ihowson/Enduro-Ebike/reference/CaV3_LinearTempSensorCalculator_v3.png

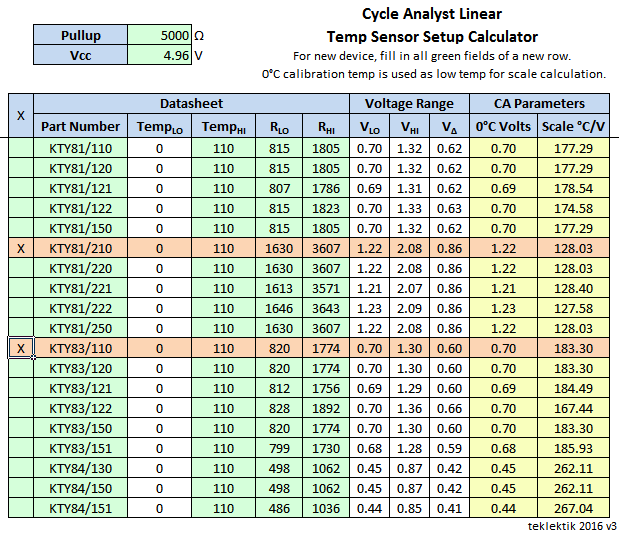
reference/CaV3_LinearTempSensorCalculator_v3.png
