ihowson/Enduro-Ebike/schematic-render.pdf

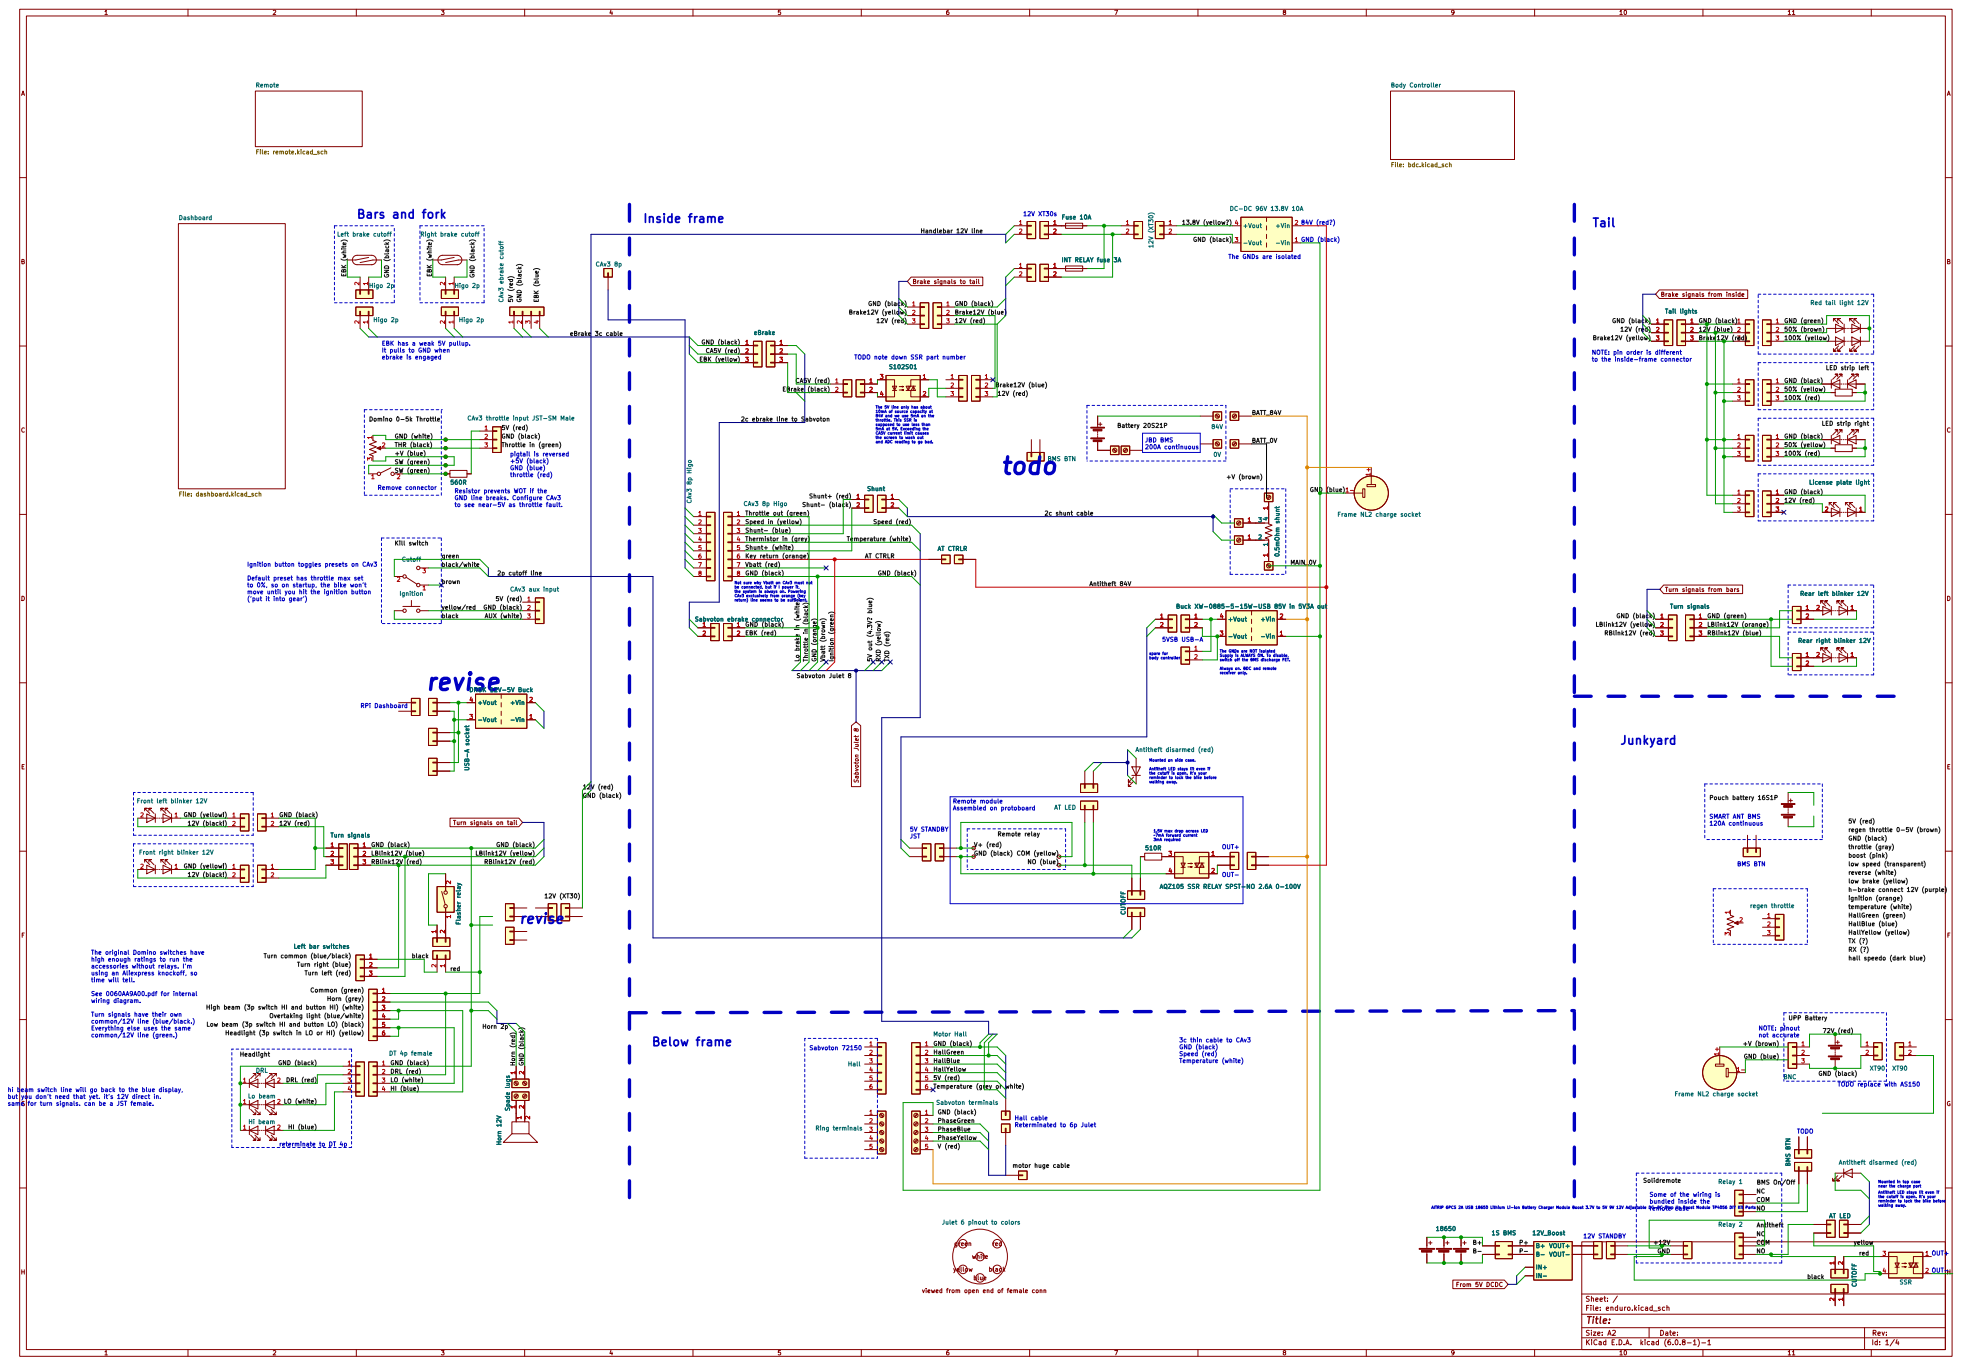
[picture p2: page 1]

Body Controller File: bdc.kicad_sch Remote File: remote.kicad_sch Dashboard File: dashboard.kicad_sch

5VSB USB-A Bars and fork
Left brake cutoff 2

to the inside-frame connector Tail

GND (black) 2c ebrake line to Sabvoton EBrake (black)

Sabvoton Julet 8 EBK (white)

Turn signals from bars GND (black)

The GNDs are isolated TODO note down SSR part number

Brake signals to tail

Brake signals from inside

EBK has a weak 5V pullup.
It pulls to GND when
ebrake is engaged

NOTE: pin order is different

The 5V line only has about 10mA of source capacity at 84V and we use 5mA on the

3 CAv3 throttle input JST-SM Male
GND (black)
Throttle in (green)
pigtail is reversed
+5V (black)
GND (blue)

5V (red)
to see near-5V as throttle fault. revise

throttle. This SSR is supposed to use less than

5mA at 5V. Exceeding the CA5V current limit causes

the screen to wash out and ADC reading to go bad.

50% (yellow) GND (orange) Vbatt (brown)

Resistor prevents WOT if the
GND line breaks. Configure CAv3

Temperature (white)
GND (black) PhaseGreen GND (black) PhaseBlue 5V out (4.3V? blue)

Antitheft disarmed (red) CUTOFF AT CTRLR

spare for body controller Ignition button toggles presets on CAv3

Default preset has throttle max set
to 0%, so on startup, the bike won't
move until you hit the ignition button
('put it into gear')

Not sure why Vbatt on CAv3 must not be connected, but if I power it,

the system is always on. Powering CAv3 exclusively from orange (key

Mounted on side case. Antitheft LED stays lit even if

Turn signals on tail

GND (black) Horn (red)
LBlink12V (yellow)
RBlink12V (red)

1.5V max drop across LED
~7mA forward current 3mA required

4AQZ105 SSR RELAY SPST-NO 2.6A 0-100V

AQZ105 SSR RELAY SPST-NO 2.6A 0-100V

The original Domino switches have
high enough ratings to run the
accessories without relays. I'm
using an Aliexpress knockoff, so
time will tell. See 0060AA9A00.pdf for internal

red Turn common (blue/black)

hall speedo (dark blue)

High beam (3p switch HI and button HI) (white)

Turn signals have their own
common/12V line (blue/black.)
Everything else uses the same

Overtaking light (blue/white)

Low beam (3p switch HI and button LO) (black)
Headlight (3p switch in LO or HI) (yellow)

hi beam switch line will go back to the blue display,
but you don't need that yet. it's 12V direct in.
same for turn signals. can be a JST female.

BMS On/Off NC
AT LED CUTOFF

Mounted in top case
near the charge port
OUT- Antitheft LED stays lit even if

Some of the wiring is bundled inside the

AITRIP 6PCS 2A USB 18650 Lithium Li-ion Battery Charger Module Boost 3.7V to 5V 9V 12V Adjustable DC-DC Step Up Boost Module TP4056 DIY Kit Parts

Julet 6 pinout to colors

viewed from open end of female conn white

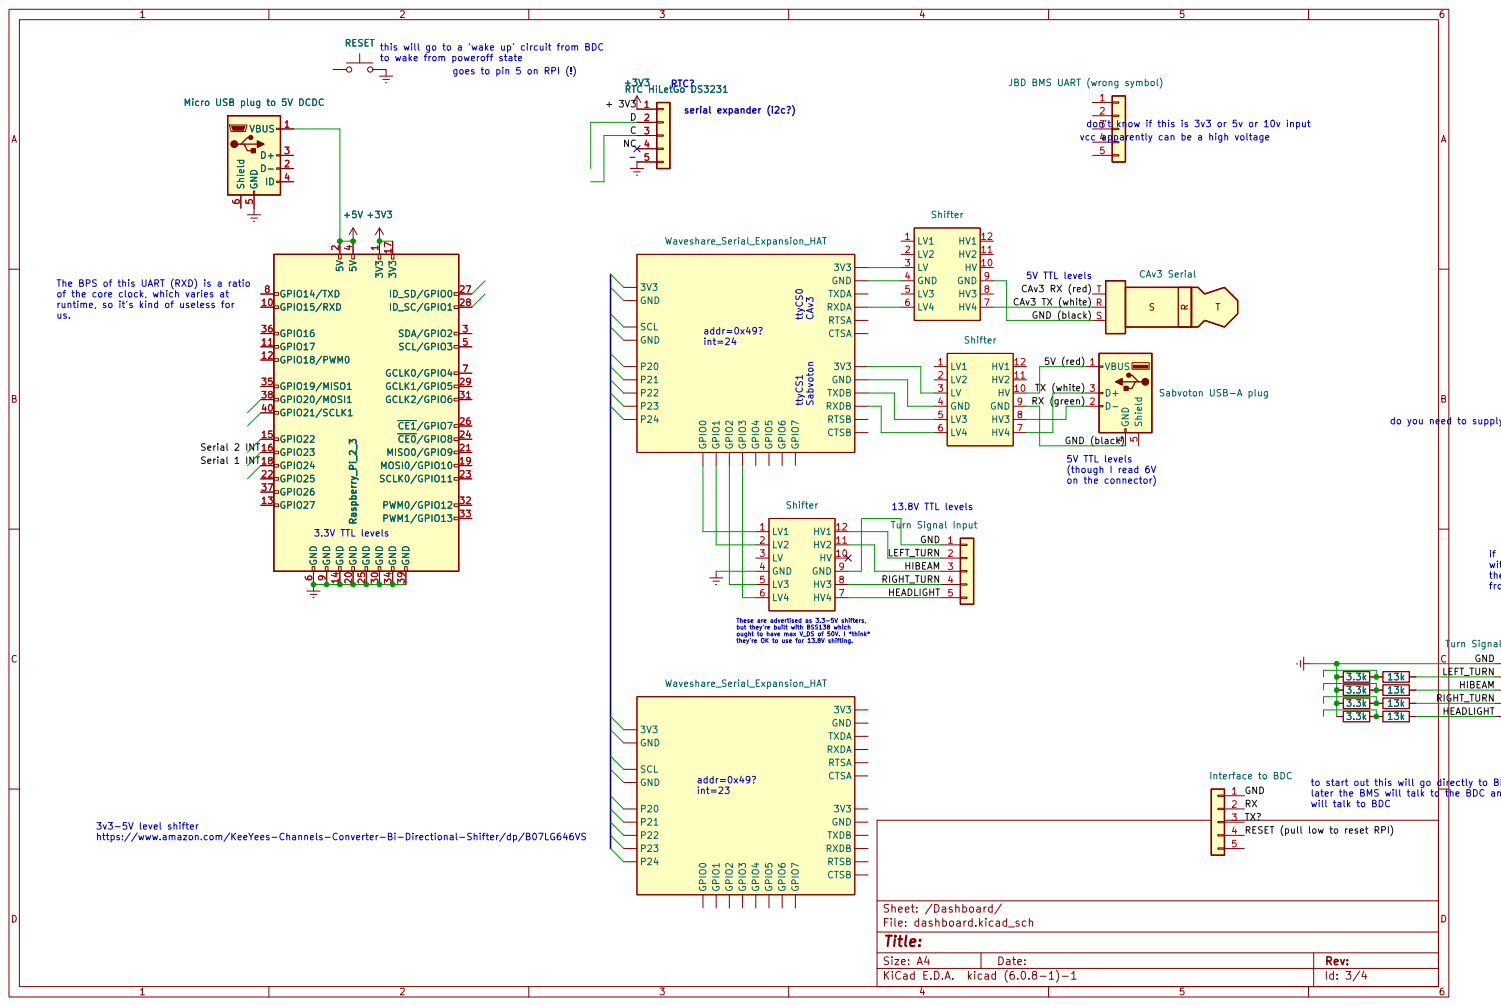
[picture p3: page 2]

don't know if this is 3v3 or 5v or 10v input addr=0x49?

this will go to a 'wake up' circuit from BDC
to wake from poweroff state

goes to pin 5 on RPI (!)

on the connector) 13.8V TTL levels RTC?

JBD BMS UART (wrong symbol)

6 Micro USB plug to 5V DCDC

5 +5V Micro USB plug to 5V DCDC

The BPS of this UART (RXD) is a ratio

T R

do you need to supply a voltage into here? 5v? 3.3V? what does the existing adapter do?

5 Turn Signal Input GND

if you just put 0v/13.8v on the HV side
without the HV supply, will that give
the result you want? will it backflow
from LV to HV side?

These are advertised as 3.3-5V shifters, but they're built with BSS138 which

ought to have max V_DS of 50V. I *think*

to start out this will go directly to BMS
later the BMS will talk to the BDC and RPi will talk to BDC

3v3-5V level shifter https://www.amazon.com/KeeYees-Channels-Converter-Bi-Directional-Shifter/dp/B07LG646VS

File: dashboard.kicad_sch Sheet: /Dashboard/
Id: 3/4 Title:

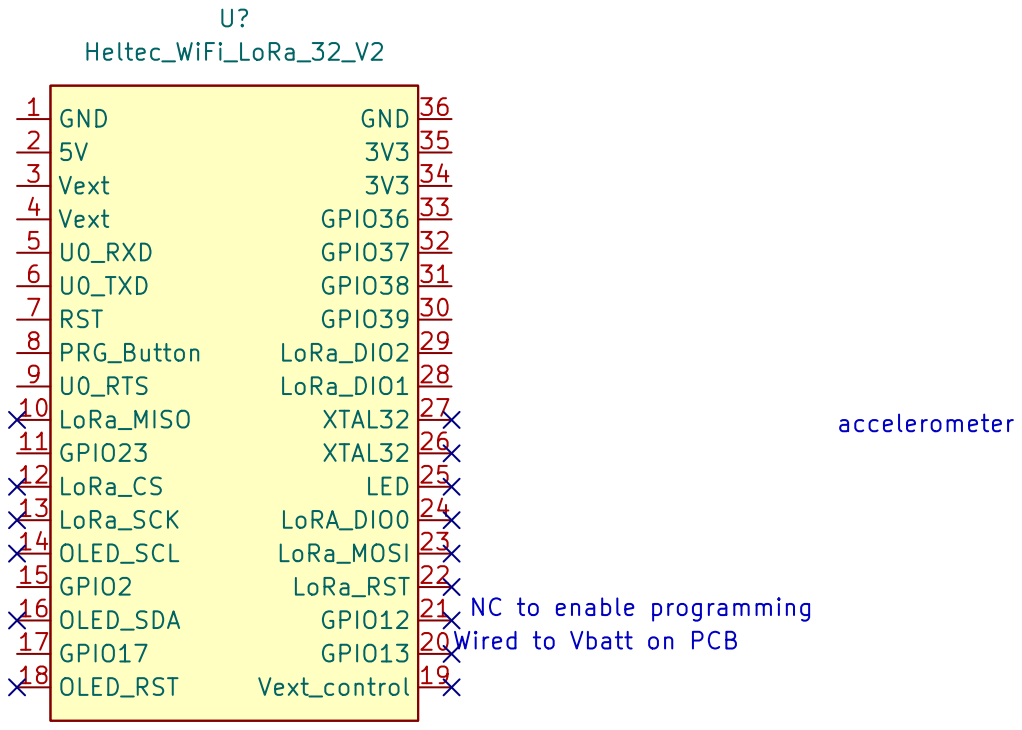
[picture p4: page 3]

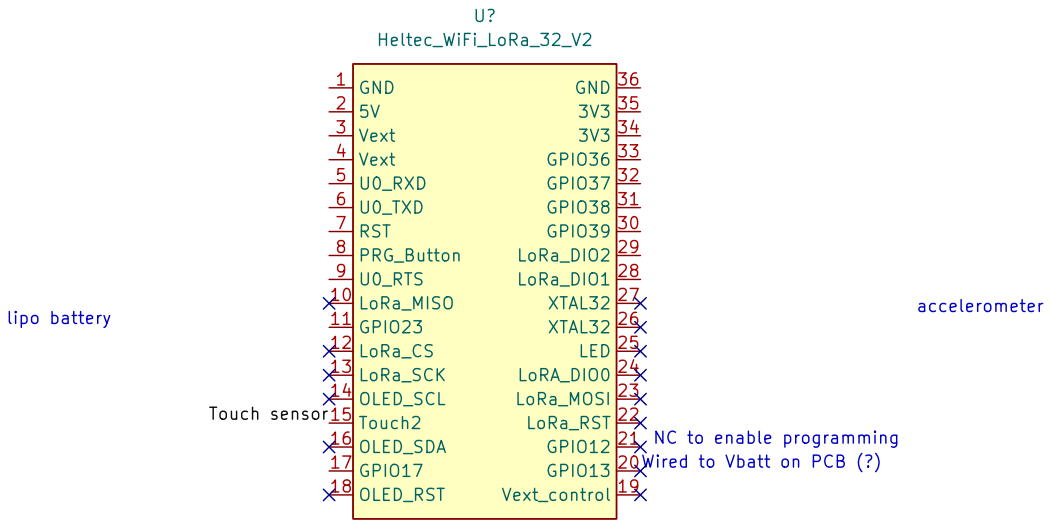
[picture p5: page 4]

NC to enable programming

File: remote.kicad_sch Sheet: /Remote/
Id: 4/4 Title:
