ihowson/Enduro-Ebike/(commit log)

2022-03-29 Initial commit. Test ridable at 220328.
    [enduro.kicad_pcb, enduro.kicad_sch]
2022-04-25 Snapshot 220425
    - The Flipsky Antispark switch blew up on first usage, so I replaced it with an SSR connected to the antitheft lines. The system is always powered on (the current BMS doesn't have an 'off' switch) but you can't drive it anywhere, and the quiescent power usage is acceptably low.
    - Moved the horn to the fork
    - Wireless antitheft! There's a small 'bootstrap' battery (1S3P 18650.) It powers a 12V boost converter which runs a Solidremote 202U two-channel relay board. This listens for 'antitheft on/off' and 'BMS pulse' signals from the remote. AT On/Off is wired to the antitheft SSR.
    - Added a 5V DCDC with three USB outputs. Its jobs are:
    1. Charge the bootstrap battery
    2.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
    [enduro.kicad_sch]
2022-10-30 5V conversion
    - Remove the internal starter pack -- it kept running flat.
    - Replace the remote receiver with a 5V version.
    - Add a 5V standby DCDC which is always on.
    - Add a switched 84V-5V DCDC which is only on when the traction power is
    on.
    - Add some early design files for the dashboard, body controller and
    remote control.
    [bdc.kicad_sch, dashboard.kicad_sch, enduro.kicad_sch, remote.kicad_sch, untitled.kicad_sch]
